FOXSPEED99/Hydro-Node/Hydro Node Parts & Schematic/Components Images/Ra-02.jpeg

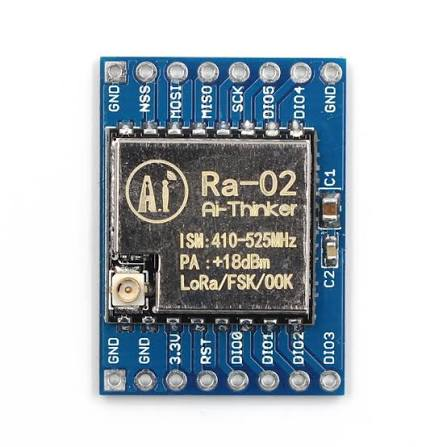
Hydro Node Parts & Schematic/Components Images/Ra-02.jpeg
