FOXSPEED99/Hydro-Node/Hydro Node Parts & Schematic/Components Images/Arduino-Pro-Mini.jpg

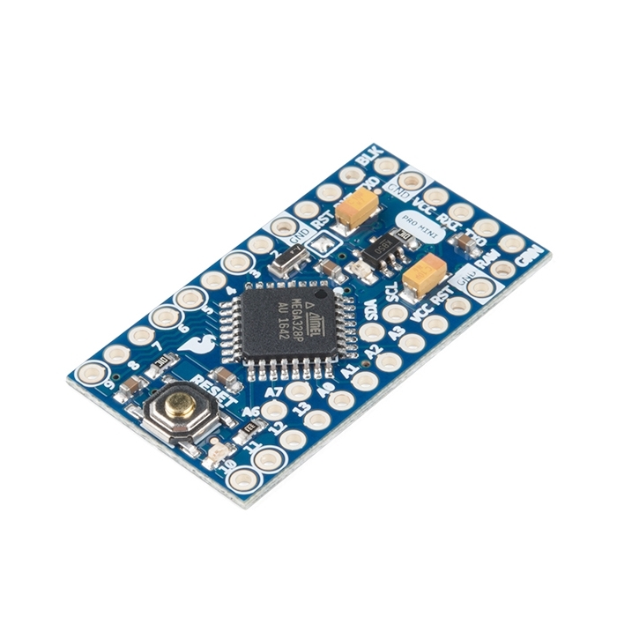
Hydro Node Parts & Schematic/Components Images/Arduino-Pro-Mini.jpg
