FOXSPEED99/Hydro-Node/Hydro Hub Device/Hydro-Hub/data/Pump-No-Filling.png

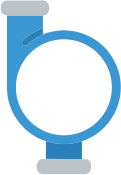
Hydro Hub Device/Hydro-Hub/data/Pump-No-Filling.png
