FOXSPEED99/Hydro-Node/Hydro Node Parts & Schematic/Components Images/1K-ohm.png

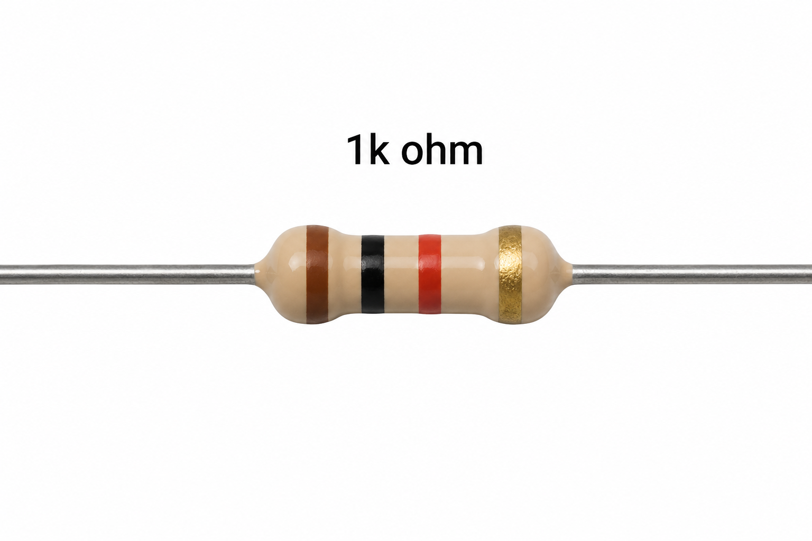
Hydro Node Parts & Schematic/Components Images/1K-ohm.png
