FOXSPEED99/Hydro-Node/Hydro Node Parts & Schematic/Components Images/1N5819.png

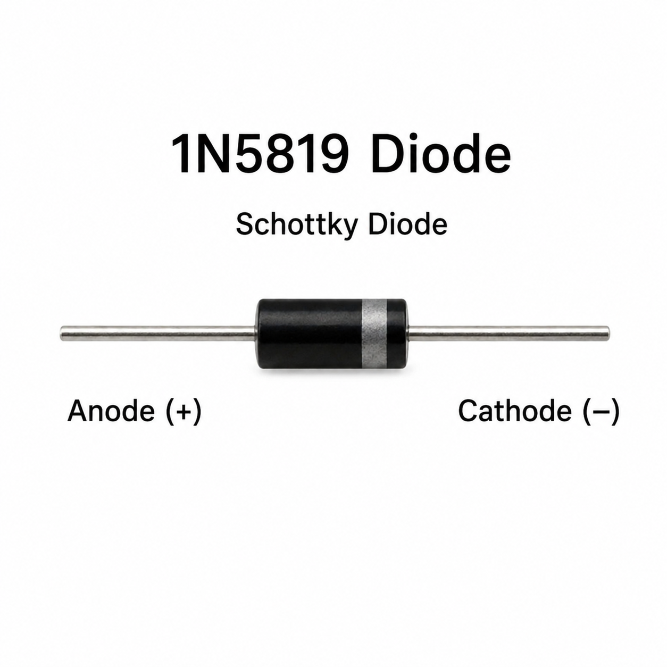
Hydro Node Parts & Schematic/Components Images/1N5819.png
