FOXSPEED99/Hydro-Node/Hydro Node Parts & Schematic/Components Images/2.2M-ohm.png

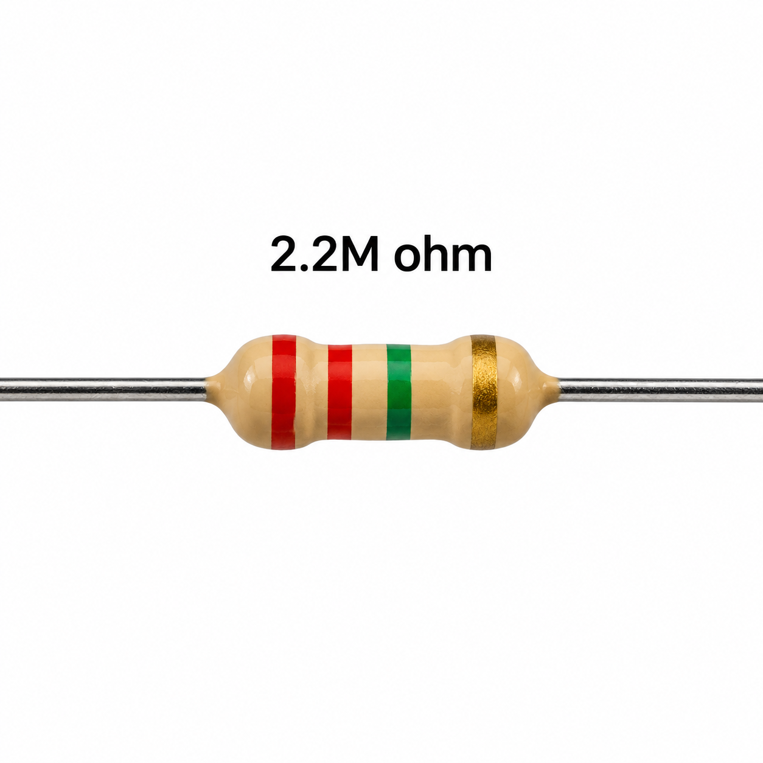
Hydro Node Parts & Schematic/Components Images/2.2M-ohm.png
