FOXSPEED99/Hydro-Node/Hydro Node Parts & Schematic/Components Images/4.7k-ohm.png

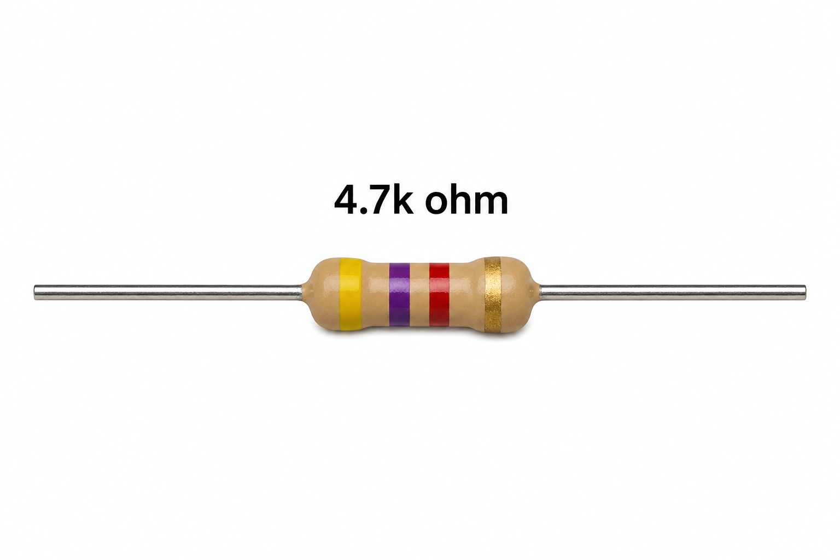
Hydro Node Parts & Schematic/Components Images/4.7k-ohm.png
