FOXSPEED99/Hydro-Node/Hydro Node Parts & Schematic/Components Images/10uf-50V.png

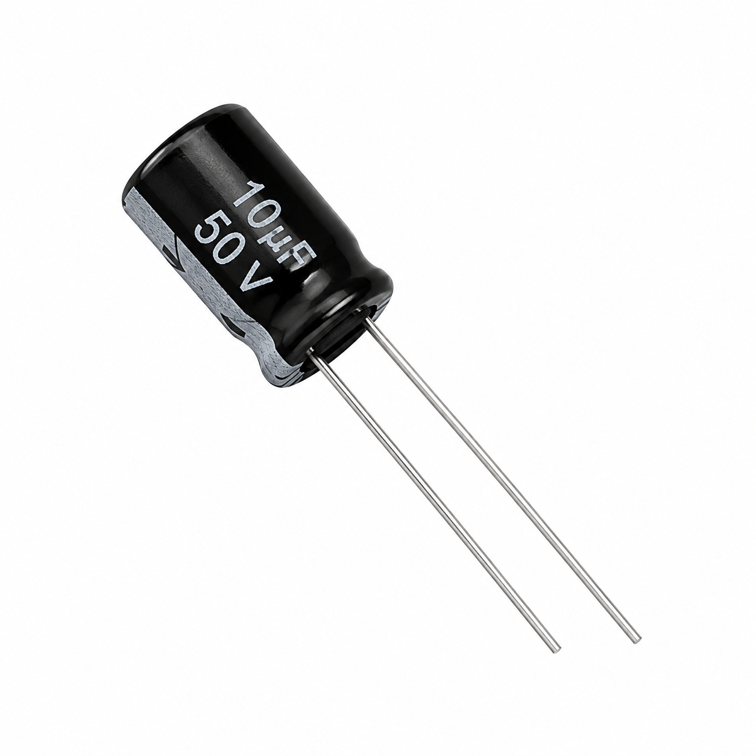
Hydro Node Parts & Schematic/Components Images/10uf-50V.png
