FOXSPEED99/Hydro-Node/Hydro Node Parts & Schematic/Components Images/74HC74AP.png

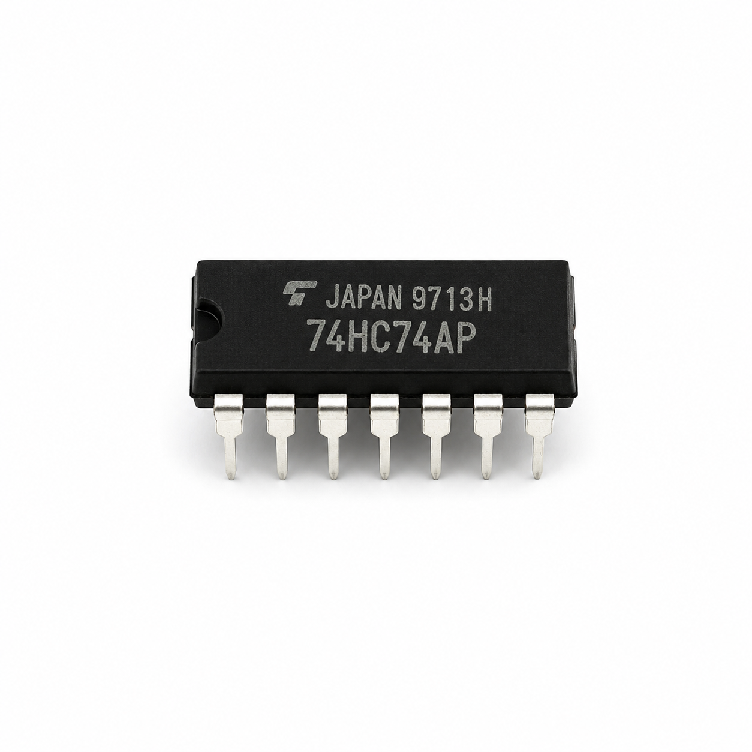
Hydro Node Parts & Schematic/Components Images/74HC74AP.png
