FOXSPEED99/Hydro-Node/Hydro Node Parts & Schematic/Components Images/100k-ohm.png

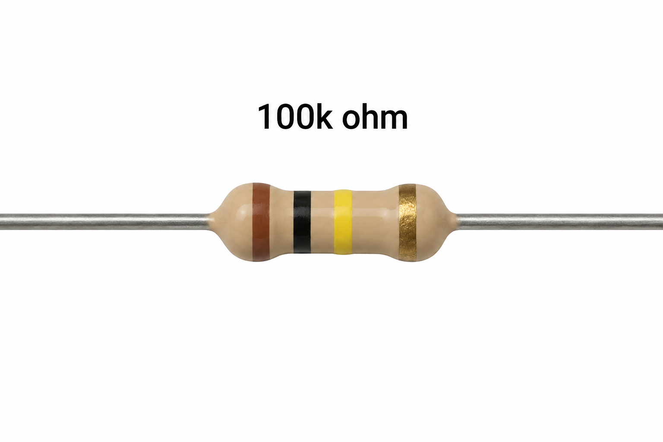
Hydro Node Parts & Schematic/Components Images/100k-ohm.png
