FOXSPEED99/Hydro-Node/Hydro Node Parts & Schematic/Components Images/100nf.png

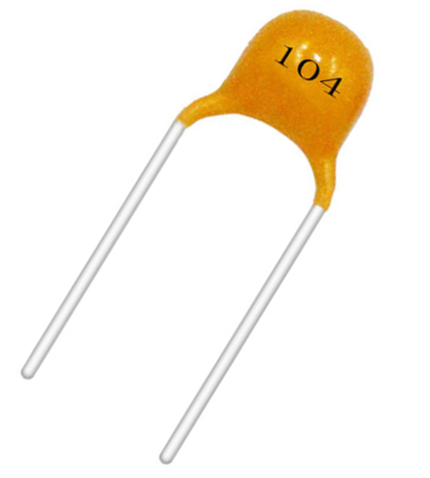
Hydro Node Parts & Schematic/Components Images/100nf.png
