FOXSPEED99/Hydro-Node/Hydro Node Parts & Schematic/Components Images/100uf-25v.png

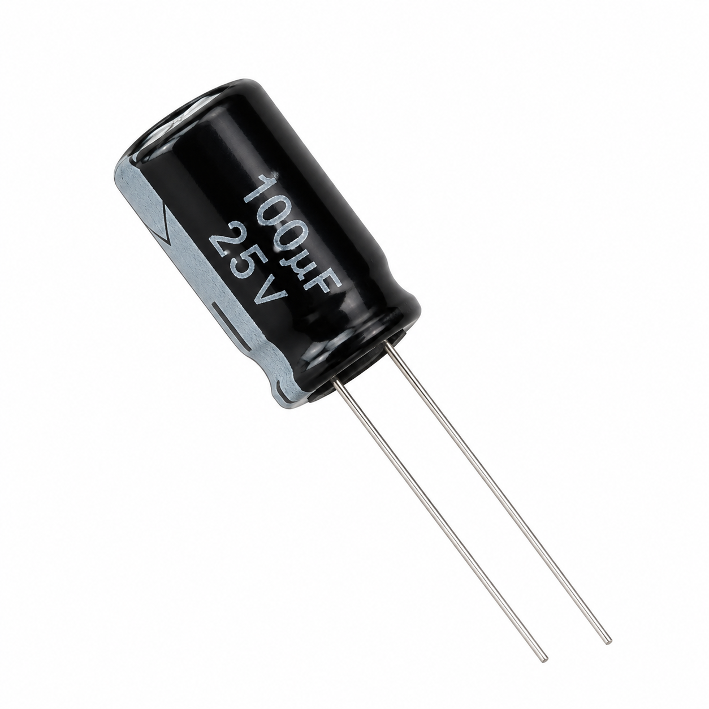
Hydro Node Parts & Schematic/Components Images/100uf-25v.png
