FOXSPEED99/Hydro-Node/Hydro Node Parts & Schematic/Components Images/B2B-XH.webp

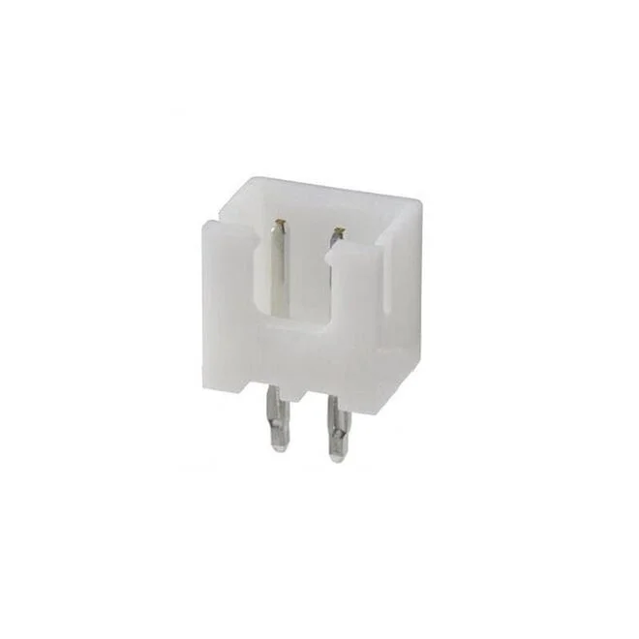
Hydro Node Parts & Schematic/Components Images/B2B-XH.webp
