FOXSPEED99/Hydro-Node/Hydro Node Parts & Schematic/Components Images/B3B-XH.jpg

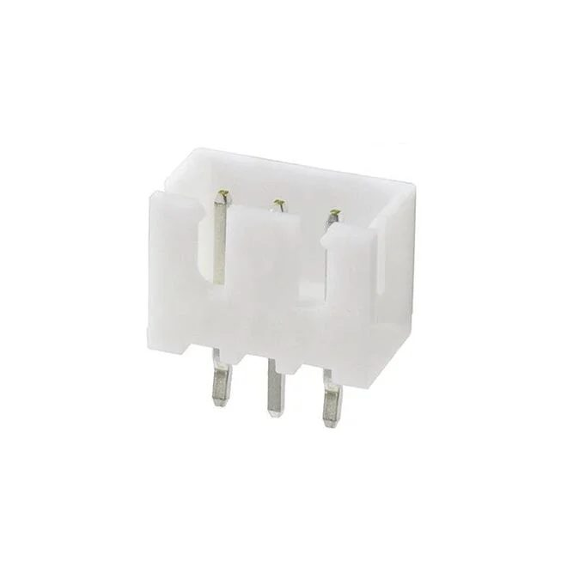
Hydro Node Parts & Schematic/Components Images/B3B-XH.jpg
