FOXSPEED99/Hydro-Node/Hydro Node Parts & Schematic/Components Images/B4B-XH.jpg

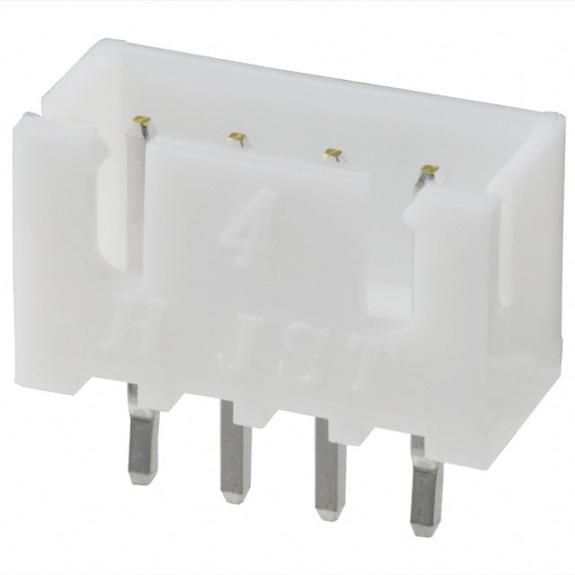
Hydro Node Parts & Schematic/Components Images/B4B-XH.jpg
