FOXSPEED99/Hydro-Node/Hydro Node Parts & Schematic/Components Images/Buzzer.png

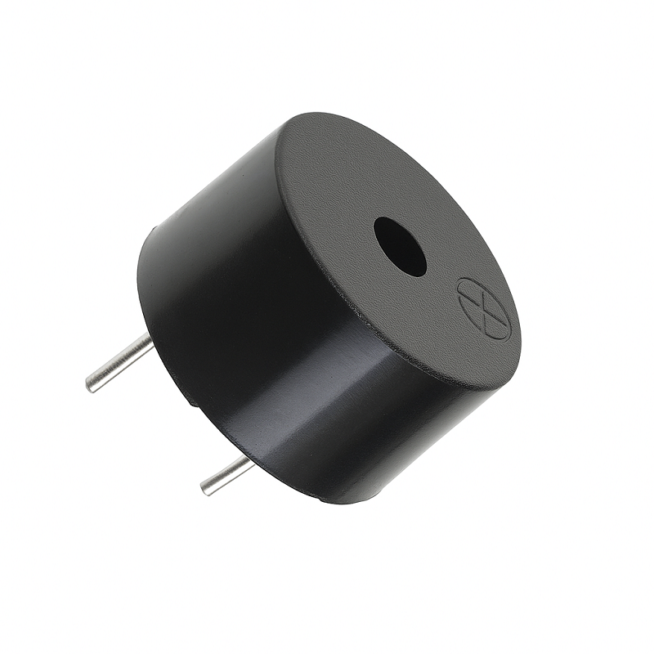
Hydro Node Parts & Schematic/Components Images/Buzzer.png
