FOXSPEED99/Hydro-Node/Hydro Node Parts & Schematic/Components Images/Flow-Switch.png

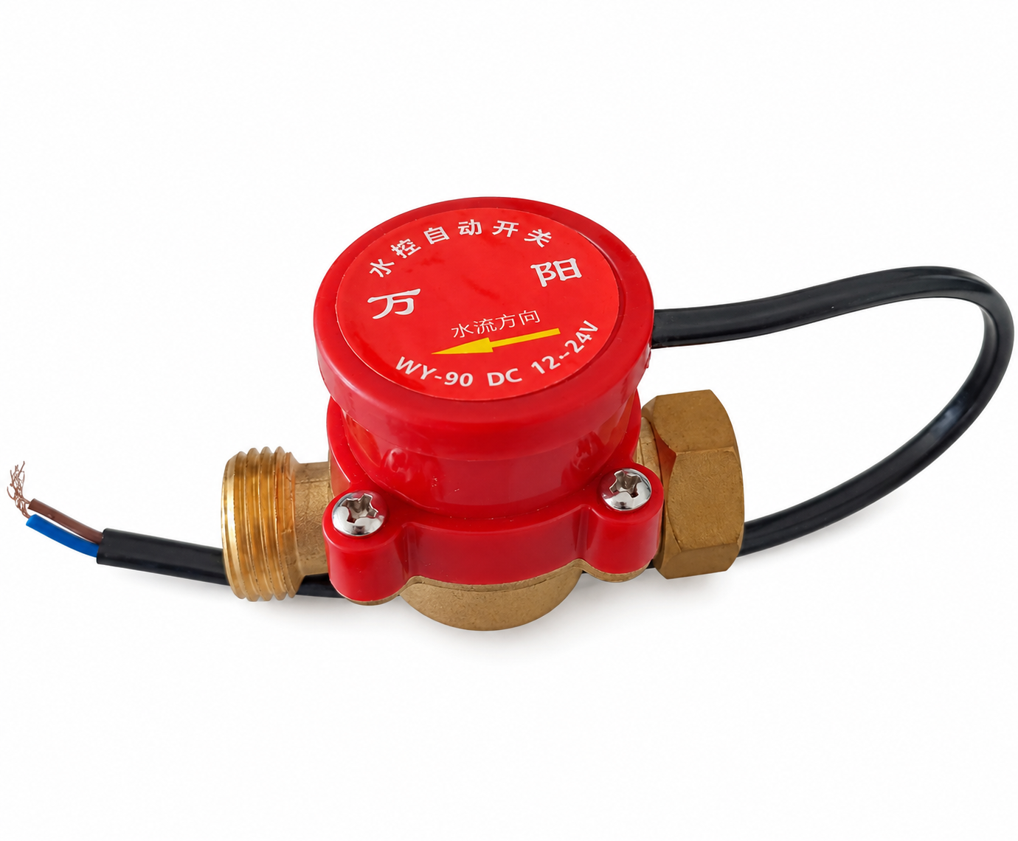
Hydro Node Parts & Schematic/Components Images/Flow-Switch.png
