FOXSPEED99/Hydro-Node/Hydro Node Parts & Schematic/Components Images/IRLZ44N.jpg

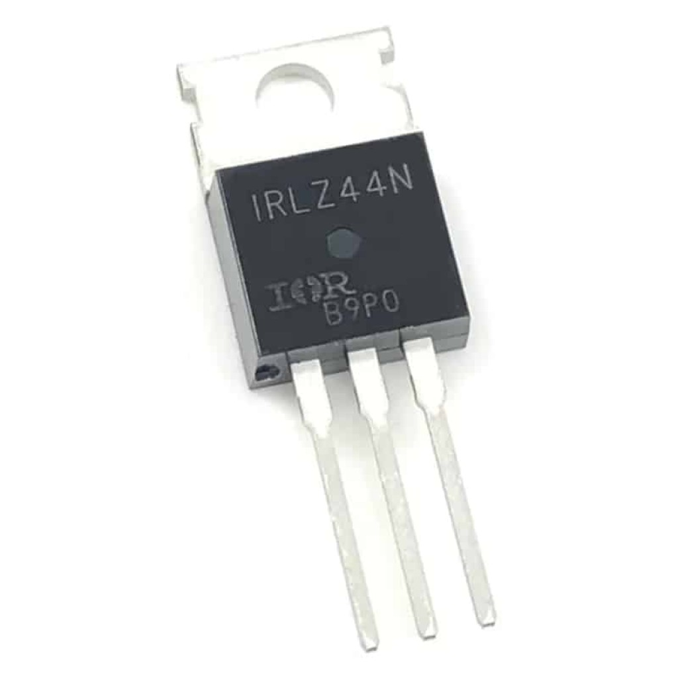
Hydro Node Parts & Schematic/Components Images/IRLZ44N.jpg
