FOXSPEED99/Hydro-Node/Hydro Node Parts & Schematic/Components Images/LS14500-3.6V.png

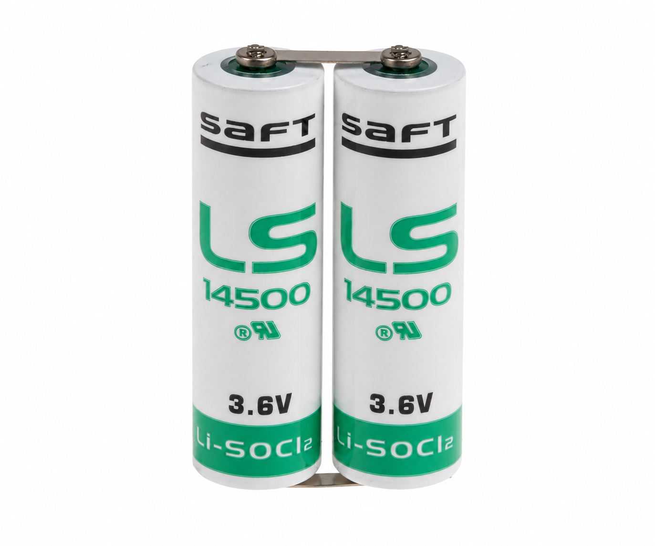
Hydro Node Parts & Schematic/Components Images/LS14500-3.6V.png
