FOXSPEED99/Hydro-Node/Hydro Node Parts & Schematic/Components Images/magnets.jpg

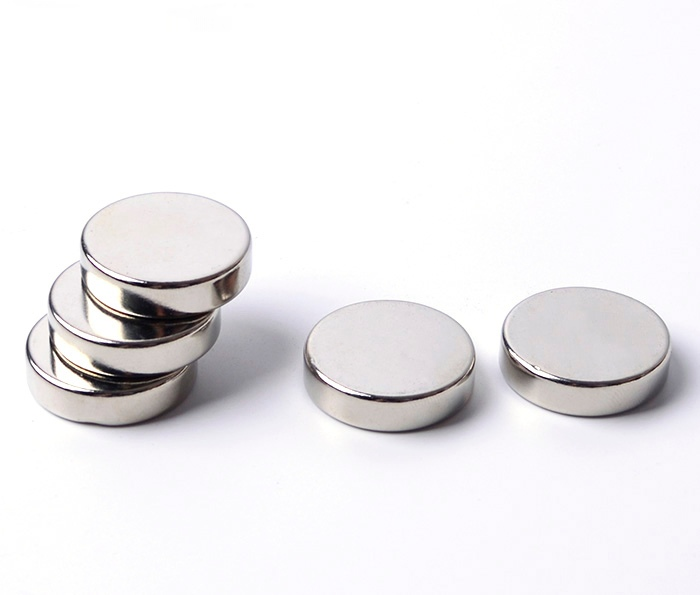
Hydro Node Parts & Schematic/Components Images/magnets.jpg
