FOXSPEED99/Hydro-Node/Hydro Node Parts & Schematic/Components Images/RCWL-1670.jpg

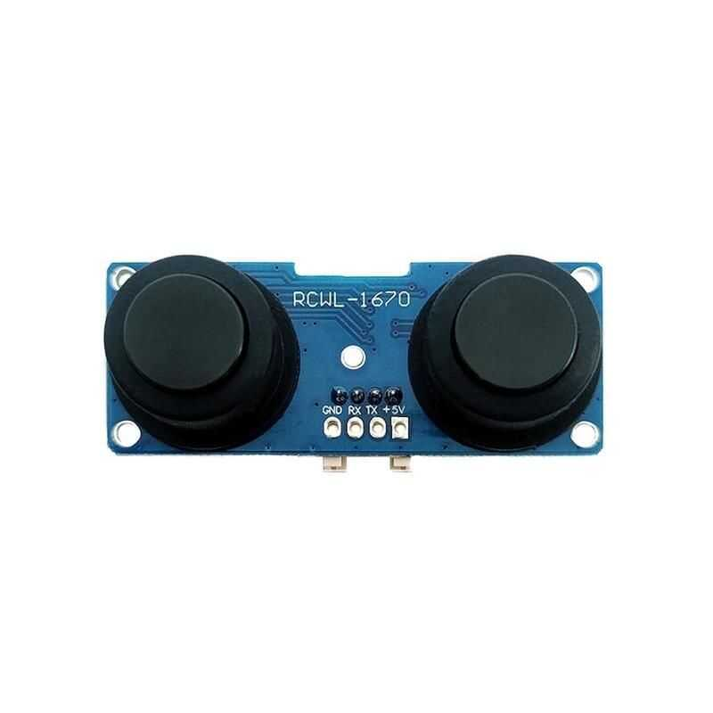
Hydro Node Parts & Schematic/Components Images/RCWL-1670.jpg
