FOXSPEED99/Hydro-Node/Hydro Node Parts & Schematic/Components Images/Reed-Switch.jpg

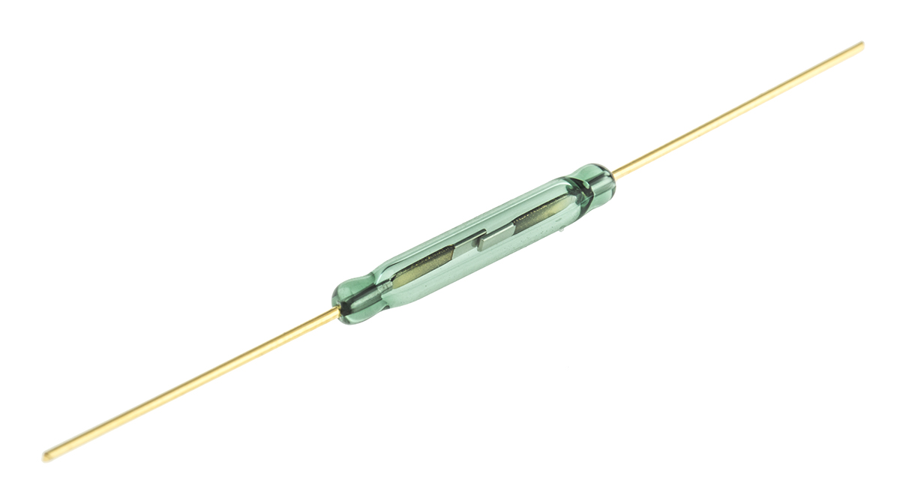
Hydro Node Parts & Schematic/Components Images/Reed-Switch.jpg
