FOXSPEED99/Hydro-Node/Hydro Node Parts & Schematic/Components Images/SMA-to-Ipex.webp

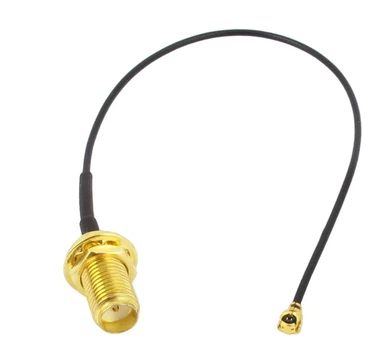
Hydro Node Parts & Schematic/Components Images/SMA-to-Ipex.webp
