FOXSPEED99/Hydro-Node/(list of files, drawings)

Other design files:
Hydro Node Parts & Schematic/Schematic/Hydro_Node_PCB.PcbDoc
Hydro Node Parts & Schematic/Schematic/Hydro_Node_Schematic.SchDoc
Hydro Node Parts & Schematic/Schematic/PCB_Project.PrjPcb
