FOXSPEED99/Hydro-Node/Hydro Hub Device/Hydro-Hub/ArabicLabels.h

#pragma once
#include <Arduino.h>

// مراقب المياه الذكي (width: 163px, height: 26px)
static constexpr int label_smart_water_monitor_width = 163;
static constexpr int label_smart_water_monitor_height = 26;
static const uint8_t label_smart_water_monitor_bits[] PROGMEM = {
  0x00, 0x00, 0x00, 0x00, 0x00, 0x00, 0x00, 0x00, 0x00, 0x00, 0x00, 0x00,
  0x00, 0x00, 0x00, 0x00, 0x00, 0x00, 0x00, 0x00, 0x00, 0x00, 0x00, 0x00,
  0x00, 0x00, 0x00, 0x00, 0x00, 0x00, 0x00, 0x00, 0x00, 0x00, 0x00, 0x00,
  0x00, 0x00, 0x00, 0x00, 0x00, 0x00, 0x00, 0x00, 0x00, 0x00, 0x00, 0x00,
  0x00, 0x00, 0x00, 0x00, 0x00, 0x00, 0x00, 0x00, 0x00, 0x00, 0x00, 0x00,
  0x00, 0x00, 0x00, 0x00, 0x00, 0x00, 0x60, 0x00, 0xC0, 0x0C, 0x00, 0xC0,
  0x00, 0x00, 0x00, 0x66, 0x00, 0x00, 0x00, 0x00, 0x18, 0x00, 0x00, 0x00,
  0x00, 0x00, 0x00, 0x78, 0x00, 0xC0, 0x0C, 0x00, 0xC0, 0x00, 0x00, 0x00,
  0x66, 0x00, 0x00, 0x00, 0x14, 0x18, 0x00, 0x00, 0x00, 0x00, 0x00, 0x00,
  0x1E, 0x40, 0xC0, 0x0C, 0x00, 0xC0, 0x00, 0x00, 0x00, 0x66, 0x00, 0x00,
  0x00, 0x00, 0x18, 0x00, 0x00, 0x00, 0x00, 0x00, 0x80, 0x07, 0x00, 0xC0,
  0x0C, 0x00, 0xC0, 0x00, 0x00, 0x00, 0x66, 0x00, 0x00, 0x00, 0x00, 0x18,
  0x00, 0x00, 0x00, 0x00, 0x00, 0xC0, 0x01, 0x00, 0xC0, 0x0C, 0x00, 0xC0,
  0x00, 0x00, 0x00, 0x66, 0x00, 0x00, 0x00, 0x38, 0x18, 0x00, 0x00, 0x00,
  0x00, 0x00, 0xC0, 0x00, 0x00, 0xC0, 0x0C, 0x80, 0xC1, 0x00, 0x00, 0x00,
  0x66, 0x00, 0x00, 0x00, 0x7C, 0x18, 0x00, 0x00, 0x00, 0x00, 0x00, 0x80,
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
  0xC9, 0x25, 0x90, 0x00, 0x08, 0x09, 0x25, 0x91, 0x00, 0x08, 0x06, 0x25,
  0x91, 0x00, 0xF0, 0xF9, 0xF8, 0x6E, 0x00, 0x00, 0x00, 0x20, 0x00, 0x00,
  0x00, 0x00, 0x1C, 0x00, 0x00, 0x00, 0x00, 0x00, 0x00, 0x00, 0x00, 0x00,
  0x00, 0x00, 0x00, 0x00, 0x00, 0x00, 0x00, 0x00
};
