FOXSPEED99/Hydro-Node/(commit log)

2026-08-19 Stage 0: Hydro Node hardware review — issue tracker and evidence
    Full audit of the Hydro Node schematic, PCB and BOM. Connectivity was rebuilt
    programmatically from the Altium binaries (the schematic carries no net labels
    or power ports, so every net is drawn geometry), and the PCB stackup and
    routing were read from the PcbDoc rather than the rendered image.
    40 findings: 6 blockers, 26 major, 8 minor.
    Blockers:
    - J5 pin order does not match the RCWL-1670 module (VCC lands on TRIG,
    Trig output lands on the supply pin)
    - Pro Mini power LED and MIC5205 LDO stay powered — ~2 mA sleep, so ~88 days
    of battery rather than the 2-year target
    - Two LS14500 Li-SOCl2 cells hard-paralleled with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
2026-08-19 Tracker v2: add HW-041 — logic family choice for the power-latch flip-flop
    Answers the question of whether the CD4013BE should become a 74HC74.
    Short version: marginally, and not for the reason you would expect. The real
    defect is that the CD4013B is run at 3.0-3.6 V, which is inside its 3-18 V
    recommended range but outside every characterisation table in the datasheet
    (5/10/15 V only). The 74HC74 fixes that, but it is LESS tolerant of slow input
    edges than the CD4013B, not more — so it needs the Schmitt buffer from HW-014
    even harder.
    The part that actually wins is the SN74HCS74: Schmitt-trigger on every input,
    no transition-rate requirement, specified 2-5.5 V. It fixes the characteri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
2026-08-19 Tracker v3: latch architecture decided — SR latch on PRE/CLR, 74HC74, rail hold-up
    Driven by the user's own finding, which was sharper than the v2 justification:
    U1 sits on the raw battery upstream of the MOSFET with no decoupling, so it
    sees the full LoRa TX droop. The CD4013BE's 3 V minimum has no margin against
    an aged, passivated or cold pack.
    New:
    - HW-042 (MAJOR) — latch supply has no hold-up. The failure is self-latching:
    glitch, MOSFET opens, load disappears, rail recovers, device stays off
    forever. Age- and temperature-correlated, so it hits a fleet at once. Fix is
    a Schottky plus 10 uF at U1 pin 14 (~6 mV sag over a 60 ms burst). Escalates
    to BLOCKER if the droop measu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
2026-08-19 Tracker v4: withdraw firmware-only OFF, keep magnet control of both directions
    The v3 HW-043 proposal made OFF firmware-dependent, which contradicts HW-021's
    own reasoning — that a hardware latch is preferable precisely because a hung
    MCU must still be switchable off with a magnet. Withdrawn.
    The real defect was never "someone waves a magnet by accident". It is that the
    reed filter is R3*C1 = 1 ms, the same order as contact bounce, so in a toggle
    latch the outcome of each deliberate gesture is close to a coin flip. The
    blink-on-startup indicator also makes a toggle self-correcting, which defuses
    most of the original concern.
    HW-043 rewritten as "add proper debounce, keep the toggle":
    - I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
2026-08-19 Tracker v5: first issue closed, blockers 6 -> 3
    HW-002 RESOLVED — power LED and MIC5205 removed per module, already done on the
    current build. Residuals recorded rather than left implicit: the per-unit rework
    burden stays under HW-026, the BOD fuse is a separate ~20 uA item, and the sleep
    current is still unmeasured so Stage 7 must confirm it.
    HW-001 BLOCKER -> MAJOR. The module is never plugged into the header; it lives
    in its own enclosure inside the tank on a 4-wire cable and the order is known.
    So it is not a functional defect. What remains is that the harness is a
    cross-over cable with no controlled drawing, and a line operator building it
    straight-through from the schematic produces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
2026-08-19 Tracker v6: battery configuration analysed against real part availability
    LS26500 is not sourceable, so the v5 "one bigger cell" recommendation is dead.
    Reworked against what is actually available (LS14500, LS14250, rechargeables).
    Key result: the parallel instinct was correct. Paralleling solves two separate
    problems at once — energy over 2 years, and peak current against the cell's
    50 mA rating. Only the direct connection is unsafe, not the topology.
    HW-003 revised recommendation: keep two LS14500 in parallel with per-cell
    isolation (ideal-diode controller preferred, low-Vf Schottky acceptable) plus a
    PTC, and cut TX power from +18 dBm.
    Answered both diode concerns:
    - Leakage: unfound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
2026-08-19 Tracker v7: Syria deployment context captured, blockers 3 -> 2
    HW-006 RESOLVED — deployment is Syria with no enforced RF power limit. The
    regulatory input to the link budget is gone, so +18 dBm is available. Only the
    regulatory half of the v6 argument for cutting TX power disappears; the battery
    half stands on its own, and two isolated cells at +18 dBm give 2.42x (2.26x once
    per-packet acks are budgeted). HW-003's mandatory power cut amended to optional.
    HW-045 answered — tank is rated potable and filled with potable water even
    though it is used for washing. Potable-rated cable, gland and potting specified
    regardless: near-zero cost delta, and it settles the question permanently rather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
2026-08-19 Tracker v8: tank geometry computed, beam containment raised to blocker
    Tank sizes received (500/1000/2000 L, plastic and metal, sensor 0.7-1.5 m above
    water), so HW-030 can be computed rather than flagged.
    HW-030 MAJOR -> BLOCKER. Beam width is D = 2*d*tan(theta/2), so a 60 degree
    cone is 1.15 m across at 1 m and 1.73 m at 1.5 m. It first reaches the sidewall
    at 0.69 m in a 500 L tank, 0.87 m in a 1000 L and 1.13 m in a 2000 L — against a
    range that starts at 0.7 m. The beam is illuminating tank internals across the
    whole useful range.
    The wall itself is not the main threat (grazing incidence reflects away). The
    threat is that the module reports the first echo above threshold, and every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
2026-08-19 Tracker v10: two issues closed, one downgraded, one held with the mechanism explained
    HW-008 WON'T FIX. Tested working on a fresh cell, and on review the operating
    point sits inside the 3.7 V rated range rather than outside it, so this was a
    margin observation not a defect. The exposure window is also short — a Li-SOCl2
    cell only sits at peak OCV until it has delivered a little charge. Residual
    recorded: ~50 mV to the rated limit leaves nothing for cell-to-cell spread, so
    re-check on a supplier change, and capture the upper rail during the HW-042 run.
    Noted that HW-003's Schottkys would incidentally add ~50 mV of margin here.
    HW-011 RESOLVED. The enclosure layout already prevents it — b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
2026-08-19 Tracker v11: flow switch re-reviewed against the correct part
    HW-019 MAJOR -> MINOR and rewritten. The original review was based on the
    component photo, which shows an HT-60 rated AC 220 V 0.5 A — a mains pump
    switch. The part actually fitted is a WY-90, DC 12-24 V, almost certainly a
    spring-loaded magnet piston on a hermetically sealed reed. The mains-contact
    argument is withdrawn.
    Added the contact physics, since the question was a fair one. A closed contact
    is not a short: it touches at a few asperities, those surfaces grow insulating
    films, and voltage is what fritts through them at roughly 0.3-0.5 V — so 3.6 V
    is comfortably sufficient and voltage is not the problem. Current is wha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
2026-08-19 Tracker v12: flow switch confirmed from the physical part
    Photo of the fitted part confirms WY-90 DC 12-24 V, brand Wanyang, described as
    a water-controlled automatic switch. Two-wire dry contact, brass body.
    New finding recorded: the cap is marked with a flow-direction arrow, so the
    switch is directional. Fitted backwards the piston never lifts and the contact
    never closes — and that failure is silent and indistinguishable from "no water
    was used", so it would never be caught from the data. Needs a marked step in the
    installation guide plus a commissioning check (run water, confirm the Hub sees
    the flag change, before leaving the roof).
    Also recorded: it is a dry contact with no polarit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
2026-09-03 Section 1 firmware: sensor acquisition and connection detection
    Production firmware for the Hydro Node's three sensors, built on the pin map
    extracted from Hydro_Node_Schematic.SchDoc rather than assumed. The Node stays
    dumb: it reports raw echo microseconds, the raw DS18B20 register and the raw
    flow-switch levels, and the Hub owns every conversion.
    Sensors
    - Ultrasonic (RCWL-1670) timed with Timer1 input capture on D8/PB0/ICP1. The
    board places echo there deliberately, so the driver uses the capture unit
    instead of pulseIn(): the edges are timestamped in hardware and the CPU
    idle-sleeps through the flight time. Five samples, median-anchored outlier
    rejection, then the mean of the s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
2026-09-03 Lay the firmware out as an Arduino IDE sketch
    Restructures firmware/ so the Arduino IDE is the primary workflow. The sources
    move into firmware/HydroNode/ as a flat sketch folder and main.cpp becomes
    HydroNode.ino, which is the layout the IDE expects. Flat rather than a src/
    subfolder on purpose: the IDE shows every file in the sketch folder as a tab,
    so hn_config.h - the file most likely to need editing - stays reachable,
    whereas files under src/ are compiled but hidden from the editor.
    There is still exactly one copy of the code. platformio.ini points src_dir at
    the sketch folder and the Makefile builds from it too, so nothing has to be
    kept in sync between build systems.
    Adds a board-se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
2026-09-03 Support swapped ultrasonic trigger and echo pins
    [hn_board.h, hn_report.cpp, hn_ultrasonic.cpp, hn_ultrasonic.h]
2026-09-03 Record the as-built ultrasonic pin order and tighten the software timing path
    Reviews and keeps the swapped-pin fix from main, merged onto the Arduino sketch
    layout, with four corrections.
    The substance of that fix is right and the evidence is conclusive: a plain
    HC-SR04 sketch with trigPin=8/echoPin=6 measures correct distances on the built
    hardware, so J3.3 -> D8 is TRIG and J3.4 -> D6 is ECHO. That is the opposite of
    what this firmware originally assumed. The assumption came from the Stage 0
    review's HW-018, which recommended moving echo to D8 for input capture; seeing
    J3.3 -> D8 in the netlist, I inferred the recommendation had been implemented.
    It had not. A working measurement outrank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
    [hn_report.cpp, hn_ultrasonic.cpp]
2026-09-03 Stop the Node having an opinion about tank geometry
    The architecture is that the Node sends raw values and the Hub owns all
    calibration - the blind zone, tank height, standoff and volume curve - because
    the Hub can be updated over Wi-Fi and a sealed rooftop Node cannot. One thing
    in the firmware quietly contradicted that.
    HN_US_PLAUSIBLE_MIN_US / MAX_US flagged a stable reading as OUT_OF_RANGE when
    it fell outside a window derived from this tank's measured geometry. The raw
    value was still transmitted, so no data was lost, but the flag itself encoded
    tank dimensions. Fitted to a taller tank, the Node would report OUT_OF_RANGE on
    perfectly good readings - a fault invented by the one componen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
2026-09-04 Restore Arduino IDE sketch layout
2026-09-05 Section 2: Node transmits, and a focused Hub receives and displays
    Adds the LoRa link between the two devices and a small Hub firmware for the
    current stage - receive, calculate, display - leaving the full Hub in
    Hydro-Hub/ untouched with its cloud, app, OTA and pump relay.
    THE WIRE FORMAT
    19 bytes of binary, defined once in hn_packet.h with a byte-identical copy in
    the Hub sketch; make check-protocol fails the build if they drift.
    The existing Hub spoke ~110-byte JSON at SF9. On LoRa the payload length is an
    energy question, not a storage one - airtime is roughly proportional to bytes
    and the radio draws ~100 mA throughout. Against 4.4 Ah usable over two years:
    JSON ~110 B @ SF9 59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
    [Dashboard.cpp, Dashboard.h, HydroHubLite.ino, HydroNode.ino, NodeLink.cpp, NodeLink.h, TankMath.cpp, TankMath.h]
2026-09-05 Fix an unplugged sensor reading as "noisy", and rework the display
    Bench findings from the first working Node-to-Hub link.
    THE REAL BUG: A MISSING ULTRASONIC REPORTED ITSELF AS A WORKING ONE
    Unplugging the ultrasonic produced "noisy" rather than "MISSING" - the most
    misleading answer available, because it sends you looking for a tuning problem
    instead of a cable.
    Cause: the filter treated any sample surviving the range check as proof the
    sensor was connected, on the principle that behaviour outranks the pull-up
    probe. But an unplugged input on a length of cable is an antenna. It picks up
    mains hum and switching noise, produces edges a timing loop cannot tell from
    echoes, and a few of them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
    [Dashboard.cpp, hn_filter.cpp, hn_ultrasonic.cpp]
2026-09-05 Section 3: sleep, battery measurement, OTA and a field log
    Prepares both devices to be left alone for a month.
    NODE - SLEEP
    Power-down between cycles with the watchdog as the wake source: ~4.5 uA asleep
    against ~4 mA awake. This is what hn_delay_ms() was routed through from the
    beginning, so no sensor module changed.
    The split matters and is documented: hn_delay_ms() handles the short waits
    inside a measurement and now idle-sleeps them, which keeps Timer0 and the echo
    capture running. The long wait between cycles uses hn_sleep_ms(), a full
    power-down that stops every clock - using that for a 1 ms poll inside a 1-Wire
    transaction would break the transaction and falls below the watchdog's 1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
    [Dashboard.cpp, Dashboard.h, FieldLog.cpp, FieldLog.h, HubNet.cpp, HubNet.h, HydroHubLite.ino, HydroNode.ino]
